Victorb101/DC-DC-Converter/Board Preview.png

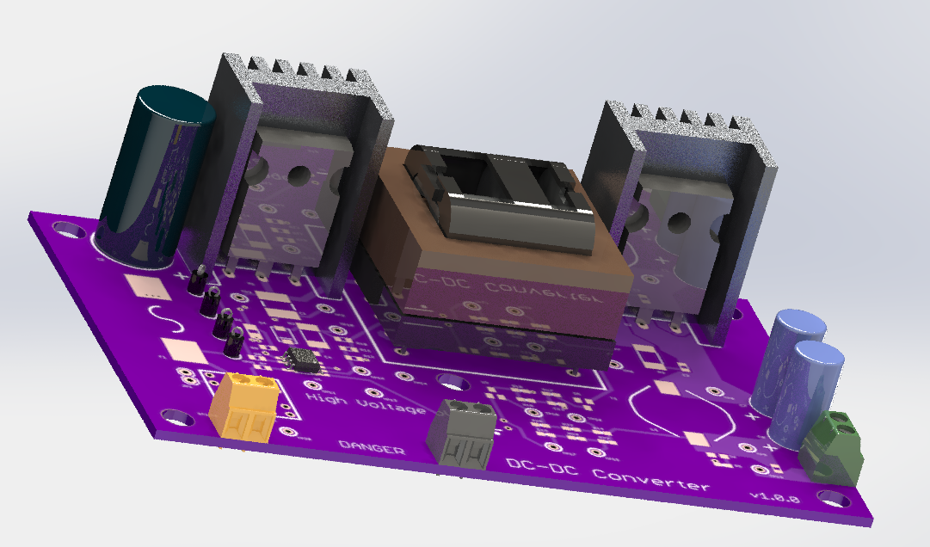
Board Preview.png
