Victorb101/DC-DC-Converter/Board Bottom.png

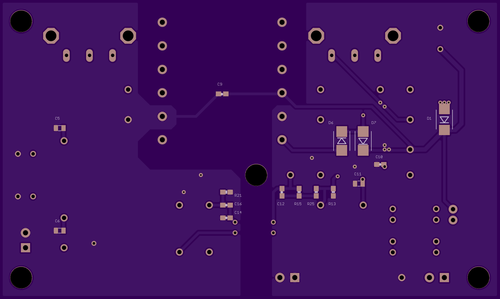
Board Bottom.png
