Victorb101/DC-DC-Converter/Board Top.png

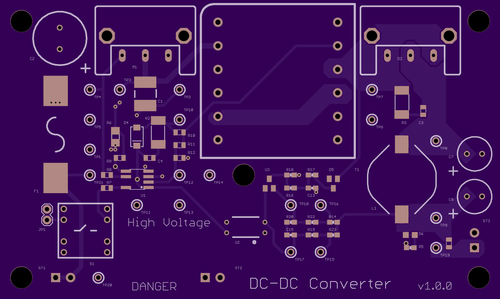
Board Top.png
