Victorb101/DC-DC-Converter/V_SNUB-PGND-Short.png

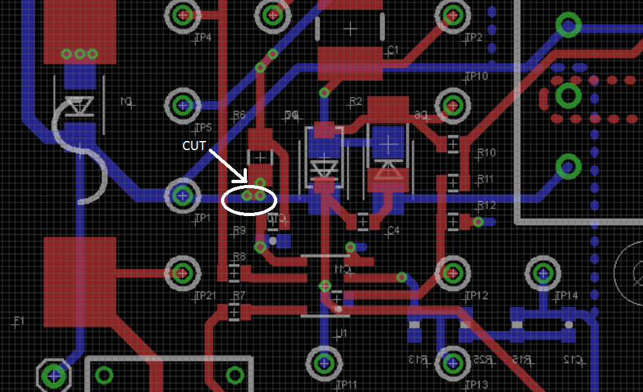
V_SNUB-PGND-Short.png
