Victorb101/DC-DC-Converter/DC-DC - Backup/BOM.xlsx

Component Type | Description | Value | Manufacturer P/N | Vendor | Vendor P/N | Package | Quantity | Need Range? | Notes
Flyback Driver | Controller (no opto) |  | UCC 28710D | Newark | 53W1981 | SOIC-7 | 1
Diode | RVP |  | STTH2L06A | DK | 497-3549-1-ND | DO-214AC, SMA | 1
MOSFET | Switch |  | IPW90R120C3 | Newark | 33P7199 | TO-247 | 1
Fuse Holder | 20mm |  | 31.8221 | DK | 486-1260-ND |  | 1
Transformer | 35:02:02 | 600uH | 7608954431 | DK | 732-5062-ND |  | 2
Button | Pushbutton |  | 15551 | DK | 679-1964-ND |  | 1
Button Cap |  |  | 1630008 | DK | 679-1973-ND |  | 1
Button Cover |  |  | 1631009 | DK | 679-1995-ND |  | 1
Heat Sink |  | 5C/W | WA-DT2-101E | DK | WA-DT2-101E-ND |  | 1
Resistor | Power - 20W | 200 | MP930-200-1% | Newark | 02H2384 | TO-220 | 1 | X | 150-200-220-250-300-400 values
Resistor | Power - 2W | 10 | CRM2512-FX-10R0ELF | Newark | 87W5948 | 2512 | 2 | X
Fuse | Quick Blow | 1A | S500-1-R. | Newark | 92K9961 | 5x20 | 2 |  | Add 2A value, 2 fuses
Screw Terminal | Orange | 2-pos | 1760490000 | Newark | 18M9779 | 5mm | 1
Screw Terminal | Black | 2-pos | 1760510000 | Newark | 14C0195 | 5mm | 1
Screw Terminal | Green | 2-pos | PT1,5/2-5.0-H | Newark | 70R0063 | 5mm | 1
Capacitor | Input | 22u | 450PX22MEFC12.5X25 | Newark | 39T8964 | 5mm | 1
Capacitor | FET Snub | 1u | CKG57NX7T2J105M500JH | DK | 445-7110-2-ND | 5x6mm | 1
Resistor | FET Snub | 100k | MC25121WF1003T4E | Newark | 04P1636 | 2512 | 1 | X
Diode | FET Snub |  | USB260-E3/52T | Newark | 12M3626 | DO-214AA | 1
Diode | Rectifier | 0.5V | STPS60L45CW | DK | 497-3745-5-ND | TO-247 | 1
Heat Sink | For Rectifier |  | WV-T247-101E | Newark | 10R0490 |  | 1
Capacitor | Rectifier Snub | 0.1u | CC0805KRX7R9BB104 | Newark | 68R4910 | 805 | 2 | X
Capacitor | Output Filter | 1u | CC0805KKX7R7BB105 | Newark | 68R4880 | 805 | 2
Capacitor | Output Filter | 270u | EEU-FR1V271L | Newark | 74R3460 | 3.5mm | 2
Inductor | Output Filter | 1u | MCBF7330-1R0MU | Newark | 74R9899 |  | 1
LED |  |  | SML-LX0805SUGC-TR | Newark | 19J8848 |  | 1
Resistor | LED | 500 | MC0063W06031510R | Newark | 58K4616 | 603 | 1
Resistor | CS | 0.25 | LRC-LR1206LF-01-R250-F | Newark | 70K8688 | 1206 | 1 | X
Resistor | CS | 3.16 | MC01W080513R16 | Newark | 94W6205 | 805 | 1 | X
Resistor |  | 0 | RC0805JR-130RL | Newark | 68R0285 | 805 | 2
Resistor | VS | 76.8k | ERJ-6ENF7682V | Newark | 53W4908 | 805 | 1
Resistor | VS | 47.5k | MC01W0805147K5 | Newark | 94W6286 | 805 | 1
Capacitor | VDD | 2.2u | C2012X7R1H225K125AC | Newark | 04X3290 | 805 | 1
Diode | VDD |  | GS1M-LTP | Newark | 51T4906 | DO-214AC | 1
Test Point |  |  | 5001 | Newark | 62W5135 |  | 10
Jumper |  |  | SPC19807 | Newark | 84K8569 | .1" | 3
Pin Header | 2 pos for jumper |  | 3-641215-2 | Newark | 52K3568 | .1" | 3
Resistor | Shunt | 0.01 | CRF0805-FX-R010ELF | Newark | 16X9679 | 805 | 1
Extras
Diode | Opto |  | BAS16-7-F | Newark | 65W8443 | SOT-23 | 1
Optocoupler | Opto |  | LTV-817A | DK | 160-2037-5-ND |  | 1
Programmable Shunt | Opto |  | TL431AIDBZT | Newark | 44J2372 | SOT-23 | 1
Future?
Heat Sink |  | 5C/W | 529801B02500G | Newark | 18M8163 |  | 1
Flyback Driver | Controller |  | UCC28740D | Newark | 12X8832 | SOIC-7 | 1
Diode | Rectifier | 0.42V | SBR10U45SP5-13 | DK | SBR10U45SP5-13DICT-ND
http://www.showmecables.com/product/DB9-Female-Terminal-Block-Panel-Mount-Connectors.aspx
