Victorb101/DC-DC-Converter/DC-DC/BOM.xlsx

Component Type | Description | Value | Manufacturer P/N | Vendor | Vendor P/N | Quantity | Unit Cost | Link
Newark Parts
Flyback Driver | Controller (no opto) |  | UCC 28710D | Newark | 53W1981 | 10 | 1.55 | http://www.newark.com/texas-instruments/ucc28710d/flyback-controller-680hz-9v-35v/dp/53W1981?CMP=AFC-OP
MOSFET | Switch |  | IPW90R120C3 | Newark | 33P7199 | 3 | 14.32 | http://www.newark.com/infineon/ipw90r120c3/n-channel-mosfet-900v-36a-to-247/dp/33P7199?ost=IPW90R120C3
Diode | FET Snub |  | USB260-E3/52T | Newark | 12M3626 | 8 | 0.5 | http://www.newark.com/vishay-general-semiconductor/usb260-e3-52t/fast-diode-2a-600v-do-214aa/dp/12M3626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
Resistor | Power - 2W | 10 | CRM2512-FX-10R0ELF | Newark | 87W5948 | 4 | 0.479 | http://www.newark.com/bourns/crm2512-fx-10r0elf/resistor-thick-film-10-ohm-1-2512/dp/87W5948?CMP=AFC-OP
 | 1W | 20 | MC25121WF200JT4E | Newark | 04P1639 | 4 | 0.178 | http://www.newark.com/multicomp/mc25121wf200jt4e/resistor-thick-film-20-ohm-1w/dp/04P1639?CMP=AFC-OP
 | 2mW | 100 | CRCW2512100RFKEG | Newark | 53K3944 | 4 | 0.35 | http://www.newark.com/vishay-dale/crcw2512100rfkeg/resistor-thick-film-chip-100-ohm/dp/53K3944?ost=53K3944
Fuse | Quick Blow | 1.5A | 048501.5DR | Newark | 69W6465 | 4 | 2.92 | http://www.newark.com/littelfuse/048501-5dr/fuse-smd-1-5a-fast-acting/dp/69W6465?CMP=AFC-OP
Screw Terminal | Orange | 2-pos | 1760490000 | Newark | 18M9779 | 2 | 0.675 | http://www.newark.com/weidmuller/1760490000/terminal-block-pcb-2pos-24-14awg/dp/18M9779?ost=18M9779
Screw Terminal | Black | 2-pos | 1760510000 | Newark | 14C0195 | 2 | 0.675 | http://www.newark.com/weidmuller/1760510000/terminal-block-pcb-2pos-24-14awg/dp/14C0195?ost=1760510000
Screw Terminal | Green | 2-pos | PT1,5/2-5.0-H | Newark | 70R0063 | 2 | 0.38 | http://www.newark.com/phoenix-contact/pt1-5-2-5-0-h/term-block-pcb-screw-5-0mm-2way/dp/70R0063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
Capacitor | Input | 22u | 450PX22MEFC12.5X25 | Newark | 39T8964 | 2 | 2.16 | http://www.newark.com/rubycon/450px22mefc12-5x25/capacitor-alum-elec-22uf-450v/dp/39T8964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
Capacitor | Rectifier Snub | 0.1u | CC0805KRX7R9BB104 | Newark | 68R4910 | 4 | 0.018 | http://www.newark.com/yageo/cc0805krx7r9bb104/capacitor-ceramic-0-1uf-50v-x7r/dp/68R4910?ost=68R4910
 |  | 0.01u | CC0805KRX7R9BB103 | Newark | 68R4909 | 4 | 0.017 | http://www.newark.com/yageo/cc0805krx7r9bb103/capacitor-ceramic-0-01uf-50v-x7r/dp/68R4909
 |  | 0.033u | MC0805B333K500CT | Newark | 06R3835 | 4 | 0.005 | http://www.newark.com/multicomp/mc0805b333k500ct/capacitor-ceramic-0-033uf-50v/dp/06R3835?ost=06R3835
 |  | 1u | UMK212BJ105KG-T | Newark | 84R9159 | 4 | 0.137 | http://www.newark.com/taiyo-yuden/umk212bj105kg-t/capacitor-ceramic-1uf-50v-x5r/dp/84R9159?ost=84R9159
 |  | 0.22u | C0805C224K5RACTU | Newark | 70K9140 | 4 | 0.117 | http://www.newark.com/kemet/c0805c224k5ractu/capacitor-ceramic-0-22uf-50v-x7r/dp/70K9140?ost=70K9140
Capacitor | Output Filter | 1u | CC0805KKX7R7BB105 | Newark | 68R4880 | 4 | 0.025 | http://www.newark.com/yageo/cc0805kkx7r7bb105/capacitor-ceramic-1uf-16v-x7r/dp/68R4880?ost=68R4880
Capacitor | Output Filter | 270u | EEU-FR1V271L | Newark | 74R3460 | 4 | 0.475 | http://www.newark.com/panasonic/eeu-fr1v271l/capacitor-alum-elec-270uf-35v/dp/74R3460?ost=74R3460
Inductor | Output Filter | 1u | MCBF7330-1R0MU | Newark | 74R9899 | 2 | 0.2 | http://www.newark.com/multicomp/mcbf7330-1r0mu/inductor-1uh-12arms-20/dp/74R9899?ost=74R9899
LED | Green |  | SML-LX0805SUGC-TR | Newark | 19J8848 | 2 | 0.169 | http://www.newark.com/lumex/sml-lx0805sugc-tr/led-green-1-25mm-x-1-4mm-45mcd/dp/19J8848?ost=19J8848
Resistor | LED | 500 | MC0063W06031510R | Newark | 58K4616 | 2 | 0.015 | http://www.newark.com/multicomp/mc0063w06031510r/resistor-510r-0-063w-1-0603/dp/58K4616?ost=58K4616
Resistor | CS | 0.25 | LRC-LR1206LF-01-R250-F | Newark | 70K8688 | 2 | 0.432 | http://www.newark.com/international-resistive/lrc-lr1206lf-01-r250-f/resistor-cur-sense-0-25-ohm-500mw/dp/70K8688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
 |  | 0.1 | CRL1206-FW-R100ELF | Newark | 32K1574 | 2 | 0.404 | http://www.newark.com/bourns/crl1206-fw-r100elf/resistor-thick-film-0-1-ohm-250mw/dp/32K1574?ost=32K1574
 |  | 0.2 | CRL1206-FW-R200ELF | Newark | 32K1581 | 2 | 0.404 | http://www.newark.com/bourns/crl1206-fw-r200elf/resistor-thick-film-0-2-ohm-250mw/dp/32K1581?ost=32K1581
 |  | 0.68 | RL1632R-R680-F | Newark | 28K1721 | 2 | 0.065 | http://www.newark.com/susumu/rl1632r-r680-f/resistor-cur-sense-0-68-ohm-500mw/dp/28K1721?ost=28K1721
Resistor | CS | 3.16 | MC01W080513R16 | Newark | 94W6205 | 2 | 0.048 | http://www.newark.com/multicomp/mc01w080513r16/resistor-3r16-0-1w-1-0805/dp/94W6205?ost=94W6205
Resistor |  | 0 | RC0805JR-130RL | Newark | 68R0285 | 8 | 0.05 | http://www.newark.com/yageo/rc0805jr-130rl/resistor-thick-film-0-ohm-125mw/dp/68R0285?ost=68R0285
Resistor | VS | 76.8k | ERJ-6ENF7682V | Newark | 53W4908 | 2 | 0.096 | http://www.newark.com/panasonic/erj-6enf7682v/resistor-thick-film-76-8kohm-125mw/dp/53W4908?ost=53W4908
Resistor | VS | 47.5k | MC01W0805147K5 | Newark | 94W6286 | 2 | 0.058 | http://www.newark.com/multicomp/mc01w0805147k5/resistor-47k5-0-1w-1-0805/dp/94W6286?ost=94W6286
 |  | 43k | ERJ-6ENF4302V | Newark | 53W4849 | 2 | 0.09 | http://www.newark.com/panasonic/erj-6enf4302v/resistor-thick-film-43kohm-125mw/dp/53W4849
 |  | 45.3k | ERJ-6ENF4532V | Newark | 53W4856 | 2 | 0.096 | http://www.newark.com/panasonic/erj-6enf4532v/resistor-thick-film-45-3kohm-125mw/dp/53W4856
 |  | 49.9k | CRCW080549K9FKEB | Newark | 65J2106 | 2 | 0.084 | http://www.newark.com/vishay-dale/crcw080549k9fkeb/resistor-thick-film-49-9kohm-125mw/dp/65J2106
 |  | 52.3k | ERJ-6ENF5232V | Newark | 53W4867 | 2 | 0.096 | http://www.newark.com/panasonic/erj-6enf5232v/resistor-thick-film-52-3kohm-125mw/dp/53W4867
Capacitor | VDD | 2.2u | C2012X7R1H225K125AC | Newark | 04X3290 | 2 | 0.509 | http://www.newark.com/tdk/c2012x7r1h225k125ac/cap-ceramic-2-2uf-50v-x7r-0805/dp/04X3290?ost=04X3290
Diode | VDD |  | GS1M-LTP | Newark | 51T4906 | 2 | 0.421 | http://www.newark.com/micro-commercial-components/gs1m-ltp/standard-recovery-1a-1kv-do-214ac/dp/51T4906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
Test Point |  |  | 5001 | Newark | 62W5135 | 42 | 0.379 | http://www.newark.com/keystone/5001/test-point-pcb-through-hole/dp/62W5135?ost=62W5135
Jumper |  |  | SPC19807 | Newark | 84K8569 | 3 | 2.36 | http://www.newark.com/multicomp/spc19807/mini-jumper-2pos-2-54mm/dp/84K8569?ost=84K8569
Resistor | Shunt | 0.01 | CRF0805-FX-R010ELF | Newark | 16X9679 | 2 | 0.501 | http://www.newark.com/bourns/crf0805-fx-r010elf/resistor-thick-film-0-01ohm-1/dp/16X9679?ost=16X9679
Diode | Opto |  | BAS16-7-F | Newark | 65W8443 | 2 | 0.074 | http://www.newark.com/multicomp/bas16-7-f/diode-ultrafast-recovery-250ma/dp/65W8443?ost=65W8443
Programmable Shunt | Opto |  | TL431AIDBZT | Newark | 44J2372 | 2 | 0.359 | http://www.newark.com/texas-instruments/tl431aidbzt/ic-prog-shunt-v-ref-2-495v-1-3/dp/44J2372?CMP=AFC-OP
Flyback Driver | Controller |  | UCC28740D | Newark | 12X8832 | 2 | 1.43 | http://www.newark.com/texas-instruments/ucc28740d/ic-cv-cc-flybk-controller-38v/dp/12X8832?CMP=AFC-OP
Digi-Key Parts
Diode | RVP |  | STTH2L06A | DK | 497-3549-1-ND | 3 | 0.6 | http://www.digikey.com/product-detail/en/STTH2L06A/497-3549-1-ND/1014952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
Transformer | 35:02:02 | 600uH | 7608954431 | DK | 732-5062-ND | 2 | 18.36 | http://www.digikey.com/product-search/en?KeyWords=732-5062-ND&WT.z_header=search_go
Button | Pushbutton |  | 15551 | DK | 679-1964-ND | 2 | 4.18 | http://www.digikey.com/product-search/en?KeyWords=679-1964-ND&WT.z_header=search_go
Button Cap |  |  | 1630008 | DK | 679-1973-ND | 2 | 0.65 | http://www.digikey.com/product-search/en?KeyWords=679-1973-ND&WT.z_header=search_go
Button Cover |  |  | 1631009 | DK | 679-1995-ND | 2 | 0.62 | http://www.digikey.com/product-search/en?KeyWords=679-1995-ND&WT.z_header=search_go
Capacitor | FET Snub | 1u | CKG57NX7T2J105M500JH | DK | 445-7110-2-ND | 2 | 5.05 | http://www.digikey.com/product-detail/en/CKG57NX7T2J105M500JH/445-7110-1-ND/2675016
 |  | 0.68u | CKG57NX7T2J684M500JH | DK | 445-10516-1-ND | 2 | 5.05 | http://www.digikey.com/product-detail/en/CKG57NX7T2J684M500JH/445-10516-1-ND/3932443
 |  | 1.5u | CKG57NX7T2W155M500JH | DK | 445-10518-1-ND | 2 | 5.05 | http://www.digikey.com/product-detail/en/CKG57NX7T2W155M500JH/445-10518-1-ND/3932445
 |  | 0.47u | CKG57NX7R2J474M500JH | DK | 445-2401-1-ND | 2 | 5.05 | http://www.digikey.com/product-detail/en/CKG57NX7R2J474M500JH/445-2401-1-ND/790022
Heat Sink | For Rectifier |  | WV-T247-101E | DK | WV-T247-101E-ND | 4 | 2.13 | http://www.digikey.com/product-detail/en/WV-T247-101E/WV-T247-101E-ND/2071312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
Diode | Rectifier | 0.5V | STPS60L45CW | DK | 497-3745-5-ND | 4 | 4.79 | http://www.digikey.com/product-search/en?KeyWords=497-3745-5-ND&WT.z_header=search_go
Pin Header |  | 2-pos | 961102-6404-AR | DK | 3M9447-ND | 2 | 0.16 | http://www.digikey.com/product-detail/en/961102-6404-AR/3M9447-ND/2071488
Optocoupler | Opto |  | LTV-817A | DK | 160-2037-5-ND | 2 | 0.41 | http://www.digikey.com/product-detail/en/LTV-817A/160-2037-5-ND/3199509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
Capacitor | Input | 4.7u | UPS2W4R7MHD1TO | DK | 493-5420-1-ND | 1 | 0.79 | http://www.digikey.com/product-detail/en/UPS2W4R7MHD1TO/493-5420-1-ND/3129757
Osh-Park Order
PCB | DC-DC |  |  | Osh-Park |  | 3 | 21.15
 |  |  |  |  |  | Total | 306.504
