Victorb101/DC-DC-Converter/DC-DC Enclosure/DC-DC Parts/XFMR.SLDASM

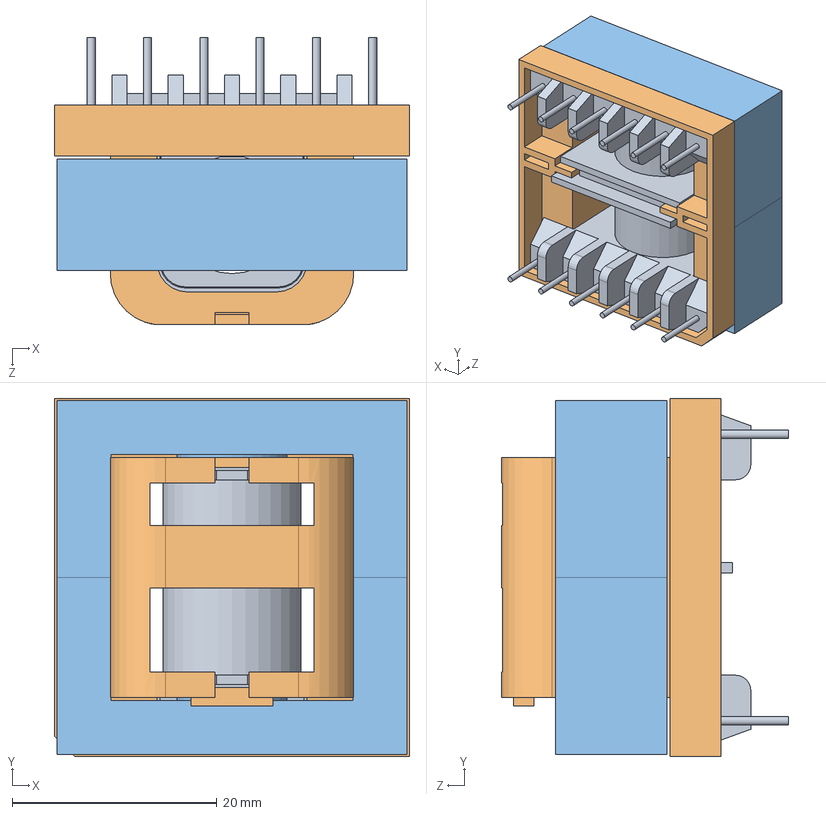
[picture p5: CAD file, 2015-01-29]
DC-DC Enclosure/DC-DC Parts/XFMR.SLDASM
34.7 x 35.0 x 28.1 mm
Bobbin_ETD34
Cover_ETD34
Core_ETD34 x 2
