Victorb101/DC-DC-Converter/DC-DC Enclosure/DC-DC Parts/Heatsink.SLDPRT

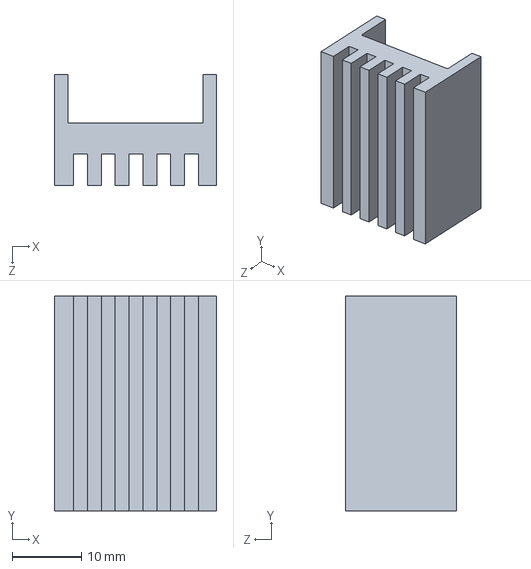
[picture p6: CAD file, 2015-01-29]
DC-DC Enclosure/DC-DC Parts/Heatsink.SLDPRT
23.4 x 31.0 x 16.0 mm
