Victorb101/DC-DC-Converter/DC-DC Enclosure/DC-DC Parts/8mCap.SLDPRT

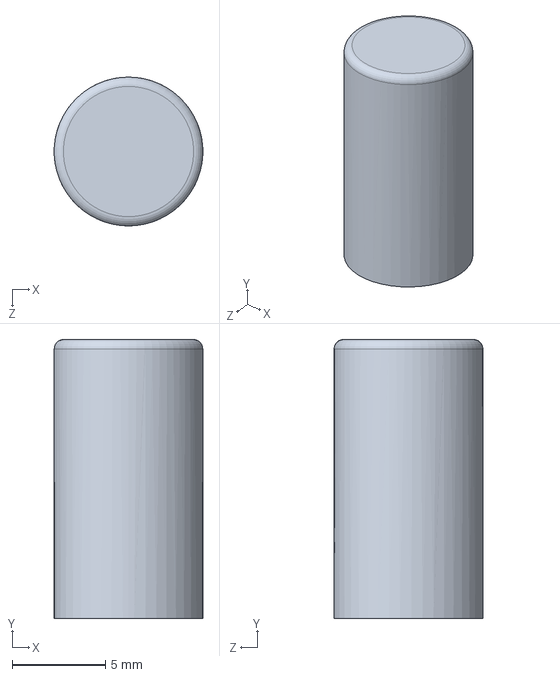
[picture p7: CAD file, 2015-01-29]
DC-DC Enclosure/DC-DC Parts/8mCap.SLDPRT
7.99 x 15.0 x 8.00 mm
