Victorb101/DC-DC-Converter/DC-DC Enclosure/DC-DC Parts/User Library-TO-247.SLDPRT

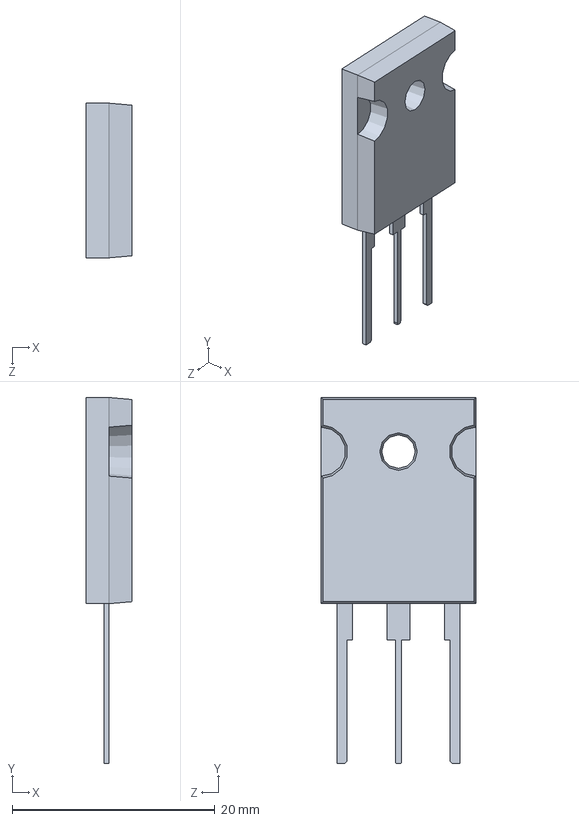
[picture p8: CAD file, 2015-01-29]
DC-DC Enclosure/DC-DC Parts/User Library-TO-247.SLDPRT
4.57 x 36.1 x 15.2 mm
