Victorb101/DC-DC-Converter/DC-DC Enclosure/DC-DC Parts/PCB.SLDPRT

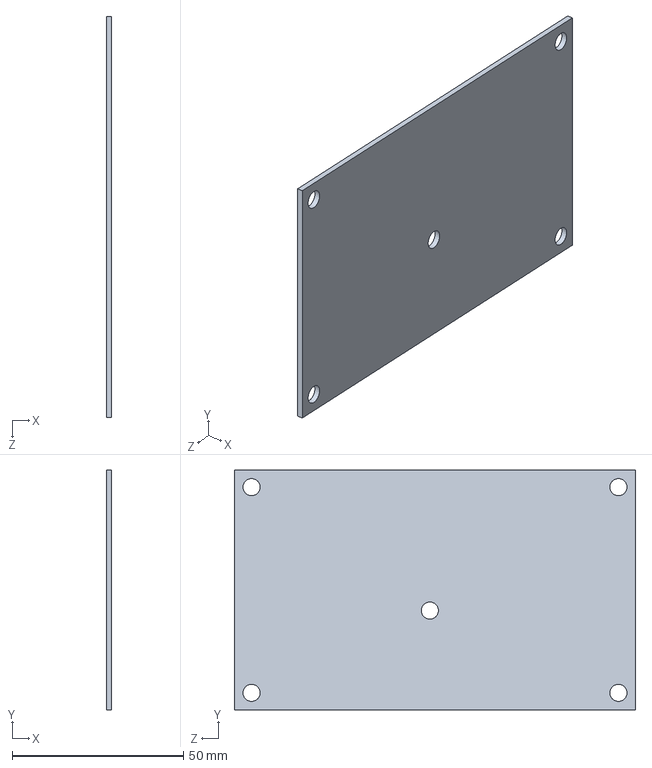
[picture p9: CAD file, 2015-01-29]
DC-DC Enclosure/DC-DC Parts/PCB.SLDPRT
1.60 x 70.0 x 117.0 mm
