Victorb101/DC-DC-Converter/DC-DC Enclosure/DC-DC Parts/User Library-SOIC-8-1.SLDPRT

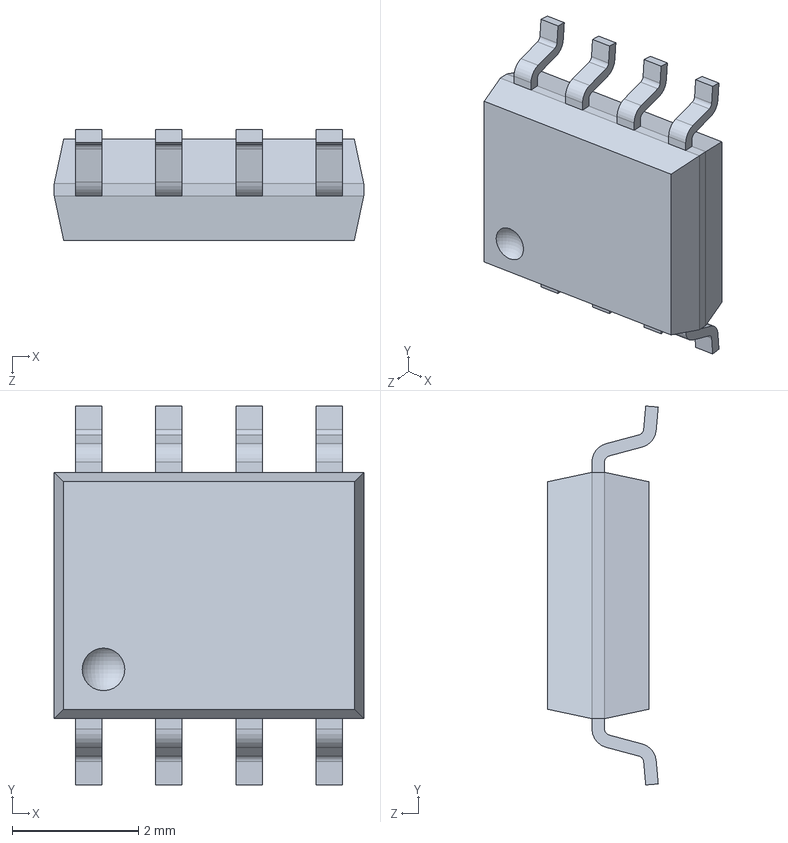
[picture p10: CAD file, 2015-01-29]
DC-DC Enclosure/DC-DC Parts/User Library-SOIC-8-1.SLDPRT
4.90 x 6.00 x 1.75 mm
