Victorb101/DC-DC-Converter/DC-DC Enclosure/DC-DC Parts/12mCap.SLDPRT

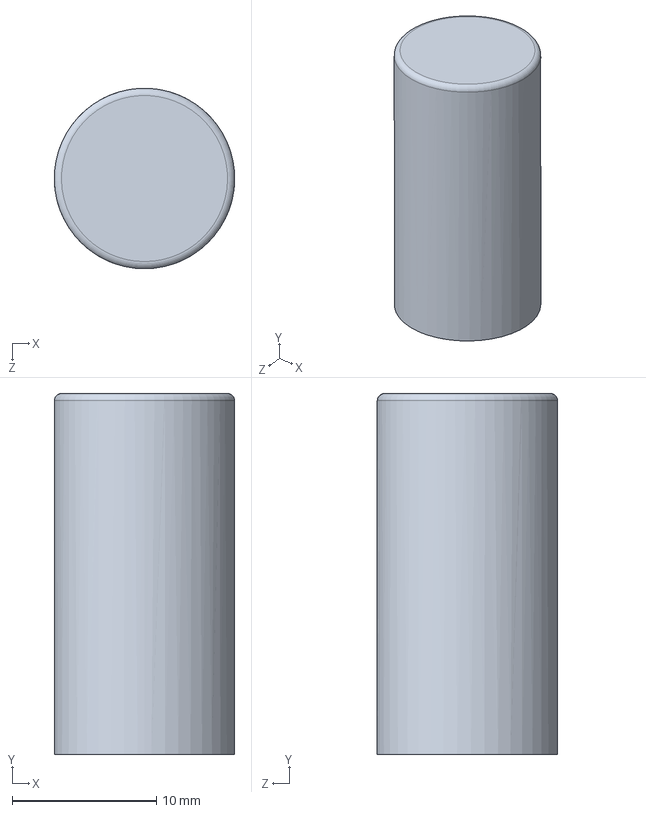
[picture p11: CAD file, 2015-01-29]
DC-DC Enclosure/DC-DC Parts/12mCap.SLDPRT
12.5 x 25.0 x 12.5 mm
