Victorb101/DC-DC-Converter/DC-DC Enclosure/DC-DC Parts/14005.SLDPRT

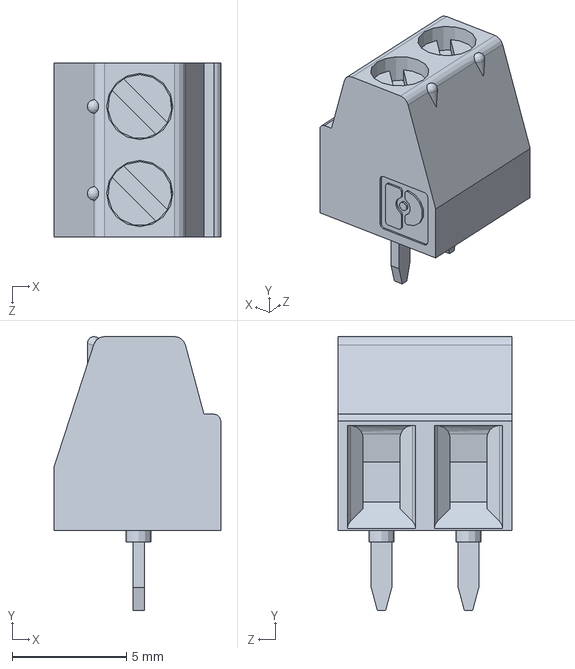
[picture p12: CAD file, 2015-01-29]
DC-DC Enclosure/DC-DC Parts/14005.SLDPRT
7.30 x 12.0 x 7.62 mm
