Victorb101/DC-DC-Converter/DC-DC Enclosure/DC-DC Parts/User Library-Test Point Keystone - 5001 BLACK.SLDASM

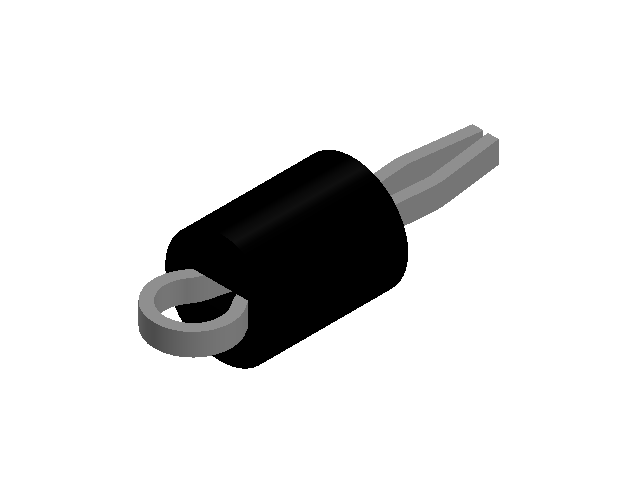
[picture p13: CAD file, 2015-01-29]
DC-DC Enclosure/DC-DC Parts/User Library-Test Point Keystone - 5001 BLACK.SLDASM
User Library-Test Point Keystone - 5001 BLACK_1
User Library-Test Point Keystone - 5001 BLACK_2
