Victorb101/DC-DC-Converter/(list of files, cad)

Other CAD files:
DC-DC Enclosure/DC-DC Parts/Bobbin_ETD34.sldprt
DC-DC Enclosure/DC-DC Parts/User Library-Test Point Keystone - 5001 BLACK_1.sldprt
DC-DC Enclosure/DC-DC Parts/Cover_ETD34.sldprt
DC-DC Enclosure/DC-DC Parts/Core_ETD34.sldprt
DC-DC Enclosure/DC-DC Parts/User Library-Test Point Keystone - 5001 BLACK_2.sldprt
