Victorb101/DC-DC-Converter/Testing/11-17-14/TEST1.png

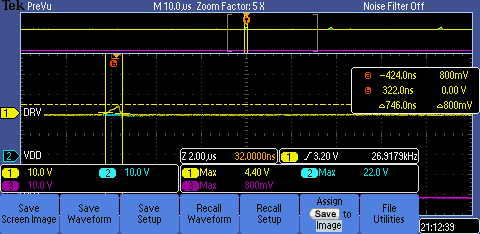
Testing/11-17-14/TEST1.png
