Victorb101/DC-DC-Converter/Testing/11-17-14/TEST1_2.png

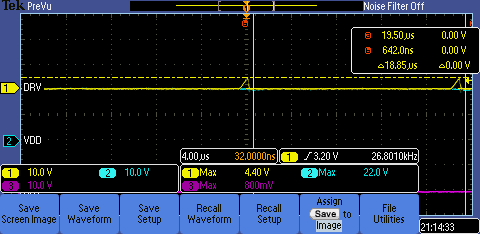
Testing/11-17-14/TEST1_2.png
