Victorb101/DC-DC-Converter/Testing/11-28-14/Test1_3.png

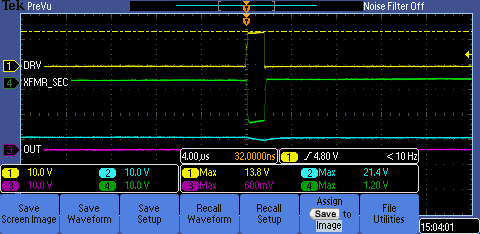
Testing/11-28-14/Test1_3.png
