Victorb101/DC-DC-Converter/Testing/11-28-14/Test3_1.PNG

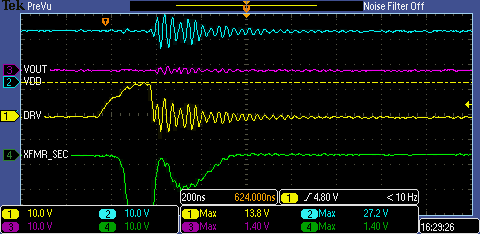
Testing/11-28-14/Test3_1.PNG
