Victorb101/DC-DC-Converter/Testing/11-30-14/Test1-2.png

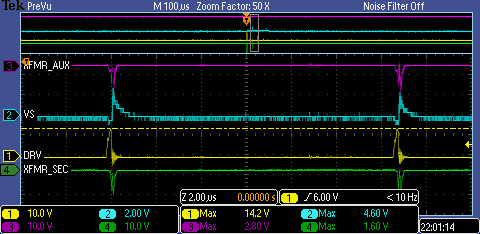
Testing/11-30-14/Test1-2.png
