Victorb101/DC-DC-Converter/Testing/11-30-14/Test2-1.PNG

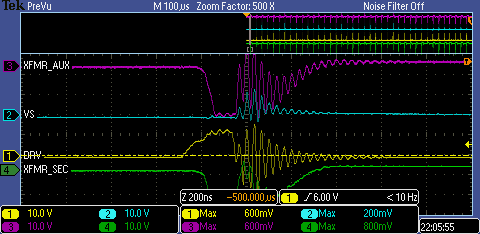
Testing/11-30-14/Test2-1.PNG
