Victorb101/DC-DC-Converter/Testing/11-30-14/Test2-2.PNG

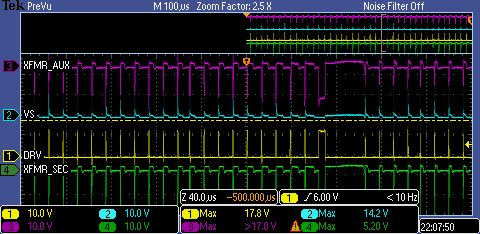
Testing/11-30-14/Test2-2.PNG
