Victorb101/DC-DC-Converter/Testing/Summary 1-22-15/TEK00005.PNG

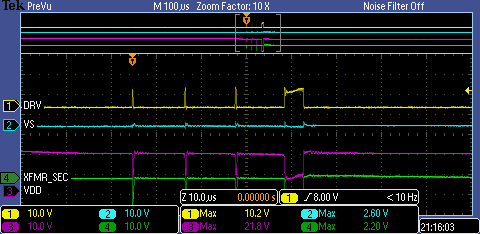
Testing/Summary 1-22-15/TEK00005.PNG
