Victorb101/DC-DC-Converter/Testing/Summary 1-22-15/TEK00007.PNG

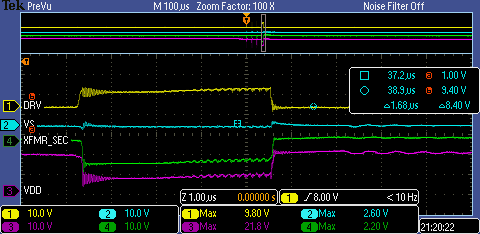
Testing/Summary 1-22-15/TEK00007.PNG
