Victorb101/DC-DC-Converter/Testing/Summary 1-22-15/DC-DC Converter v1.1.pdf

# Sheet 1/3

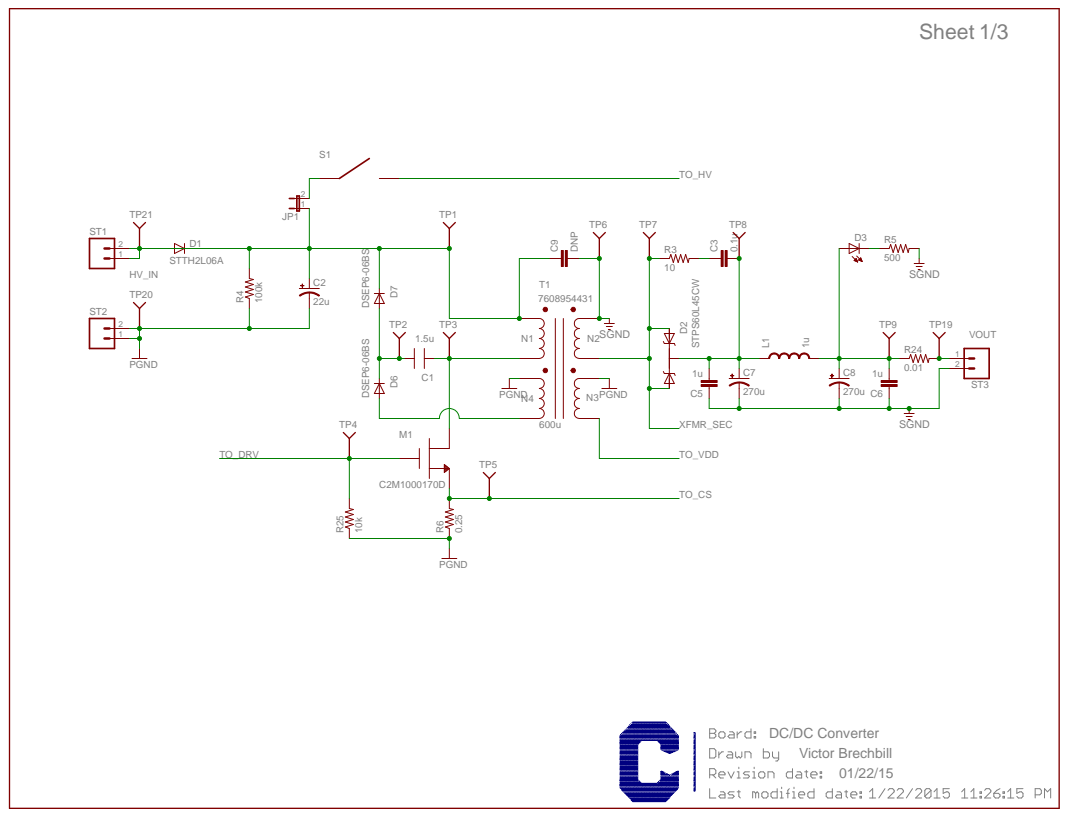
[picture p34: page 1]

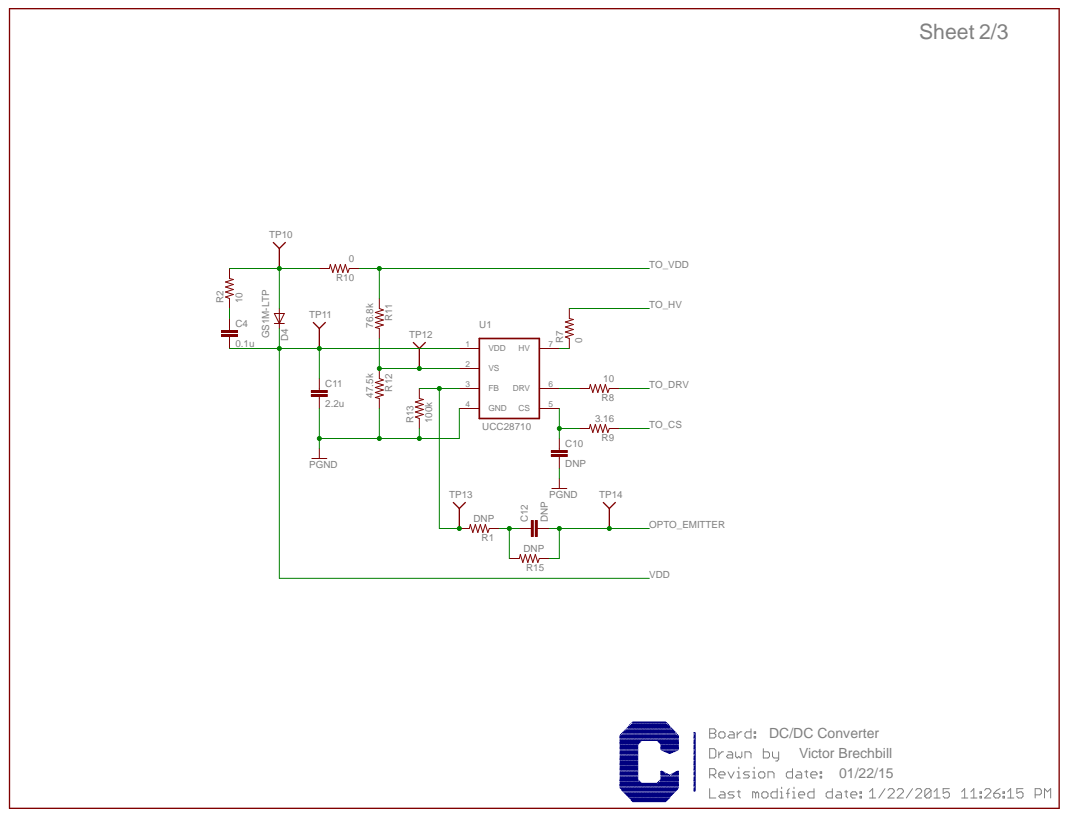
[picture p35: page 2]

# Optocoupler feedback circuit for future development with UCC28740

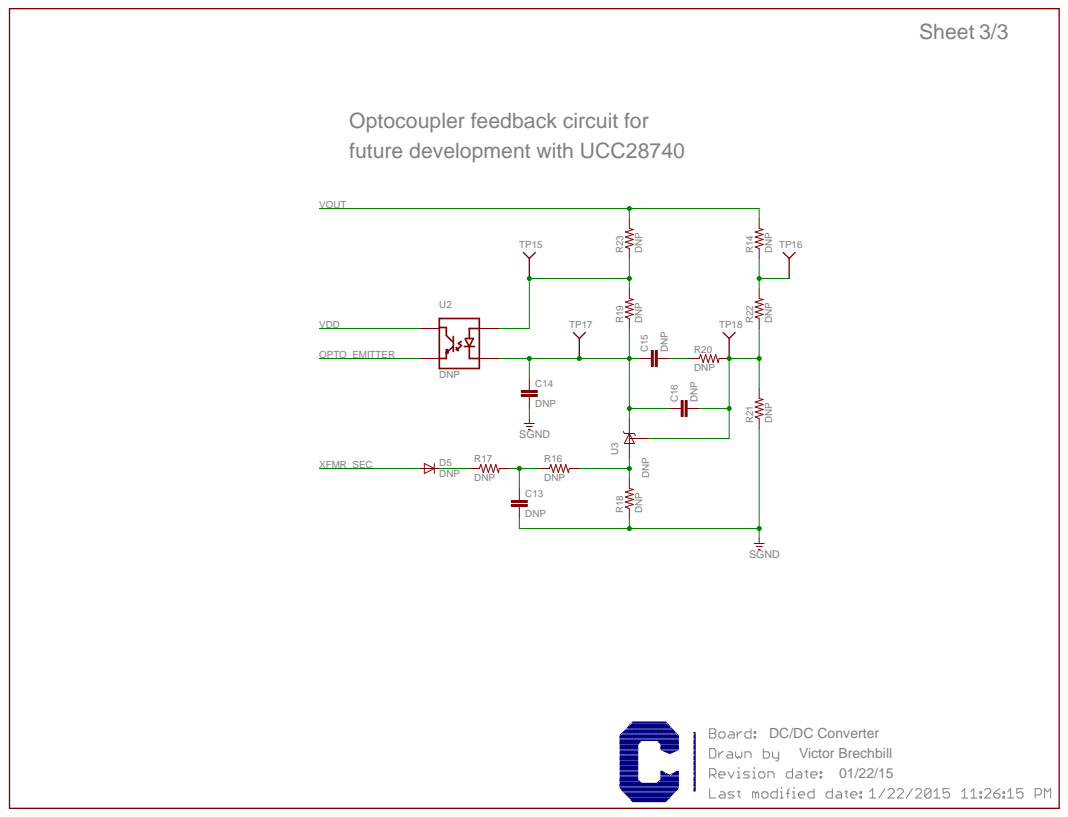
[picture p36: page 3]
