Victorb101/DC-DC-Converter/DC-DC Converter v1.1.pdf

# Sheet 1/3

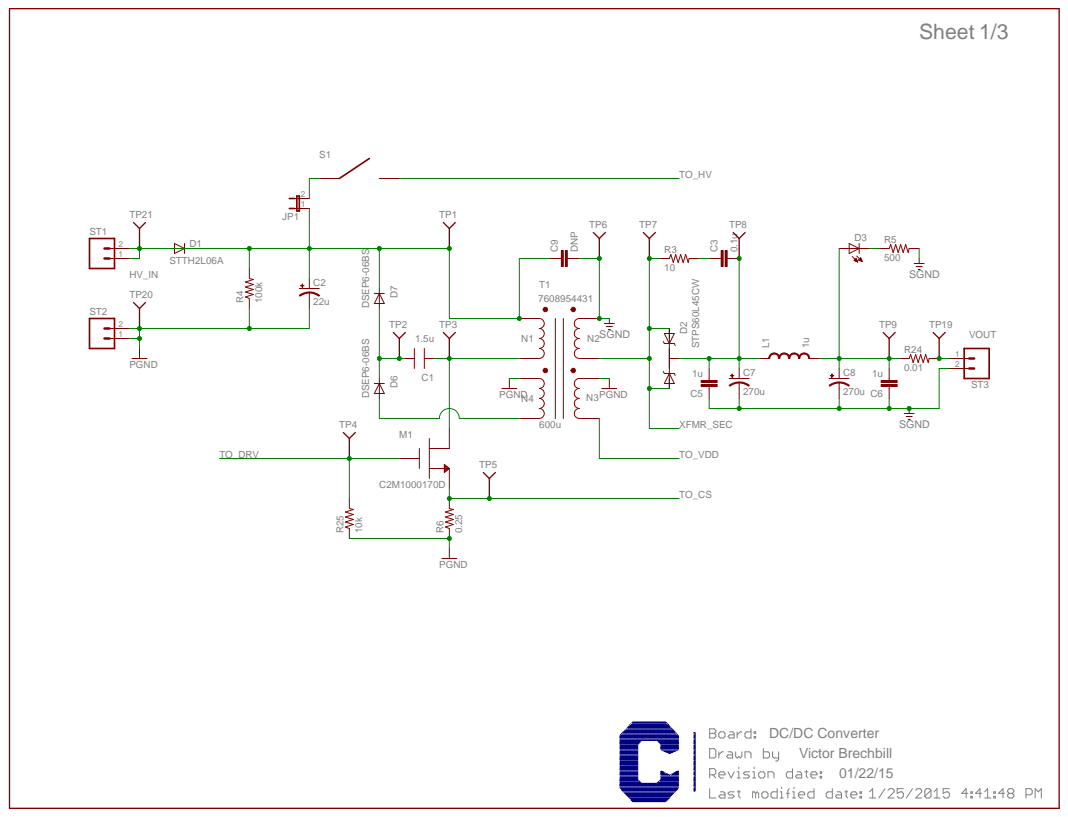
[picture p37: page 1]

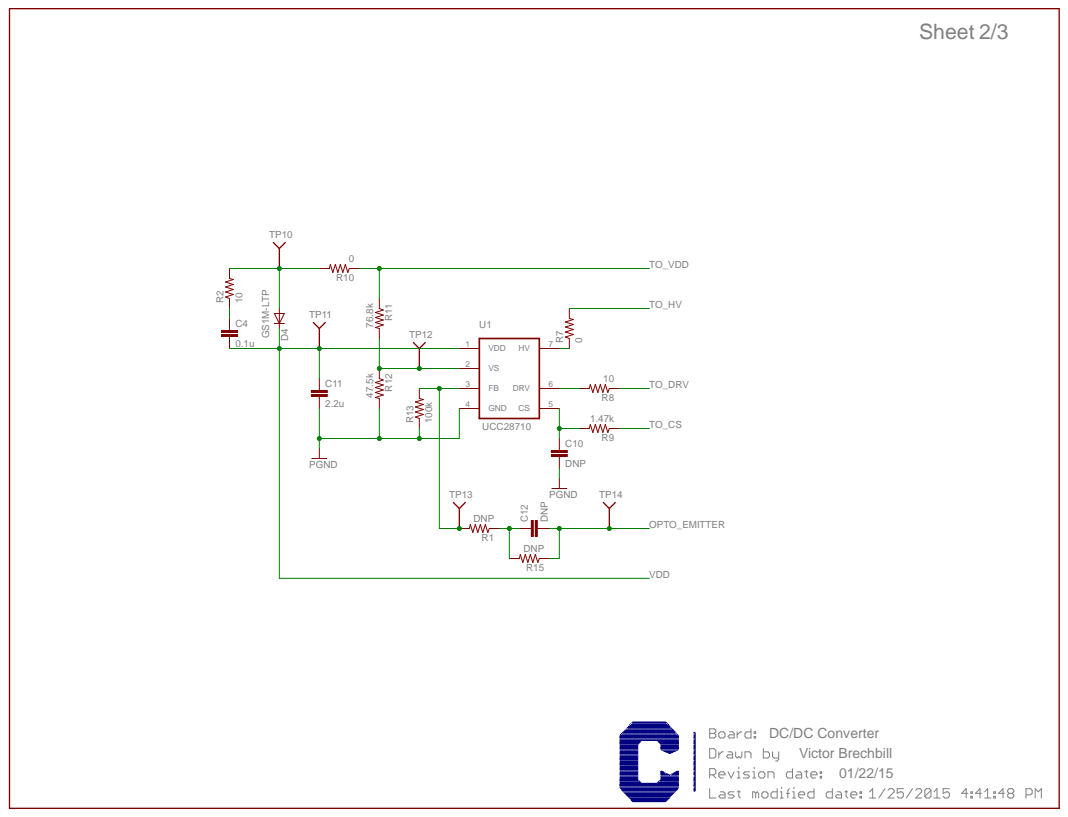
[picture p38: page 2]

# Optocoupler feedback circuit for future development with UCC28740

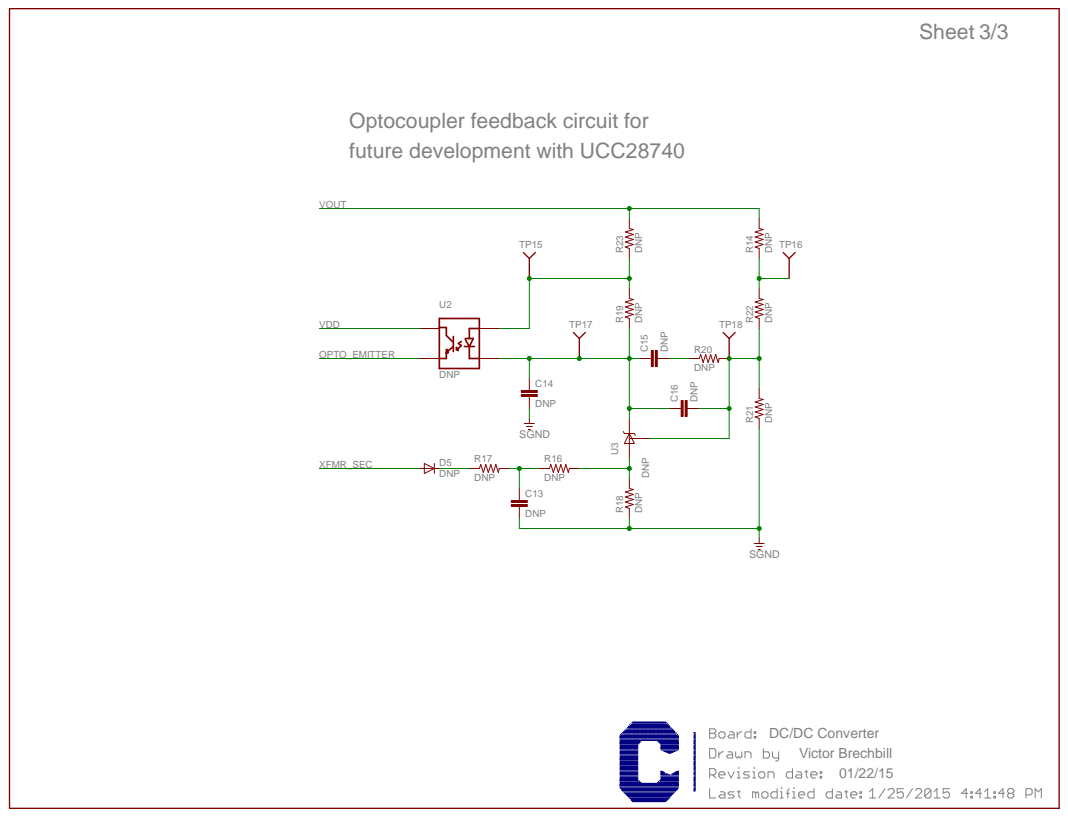
[picture p39: page 3]
