Victorb101/DC-DC-Converter/DC-DC-v1.0.0.pdf

# Sheet 1/3

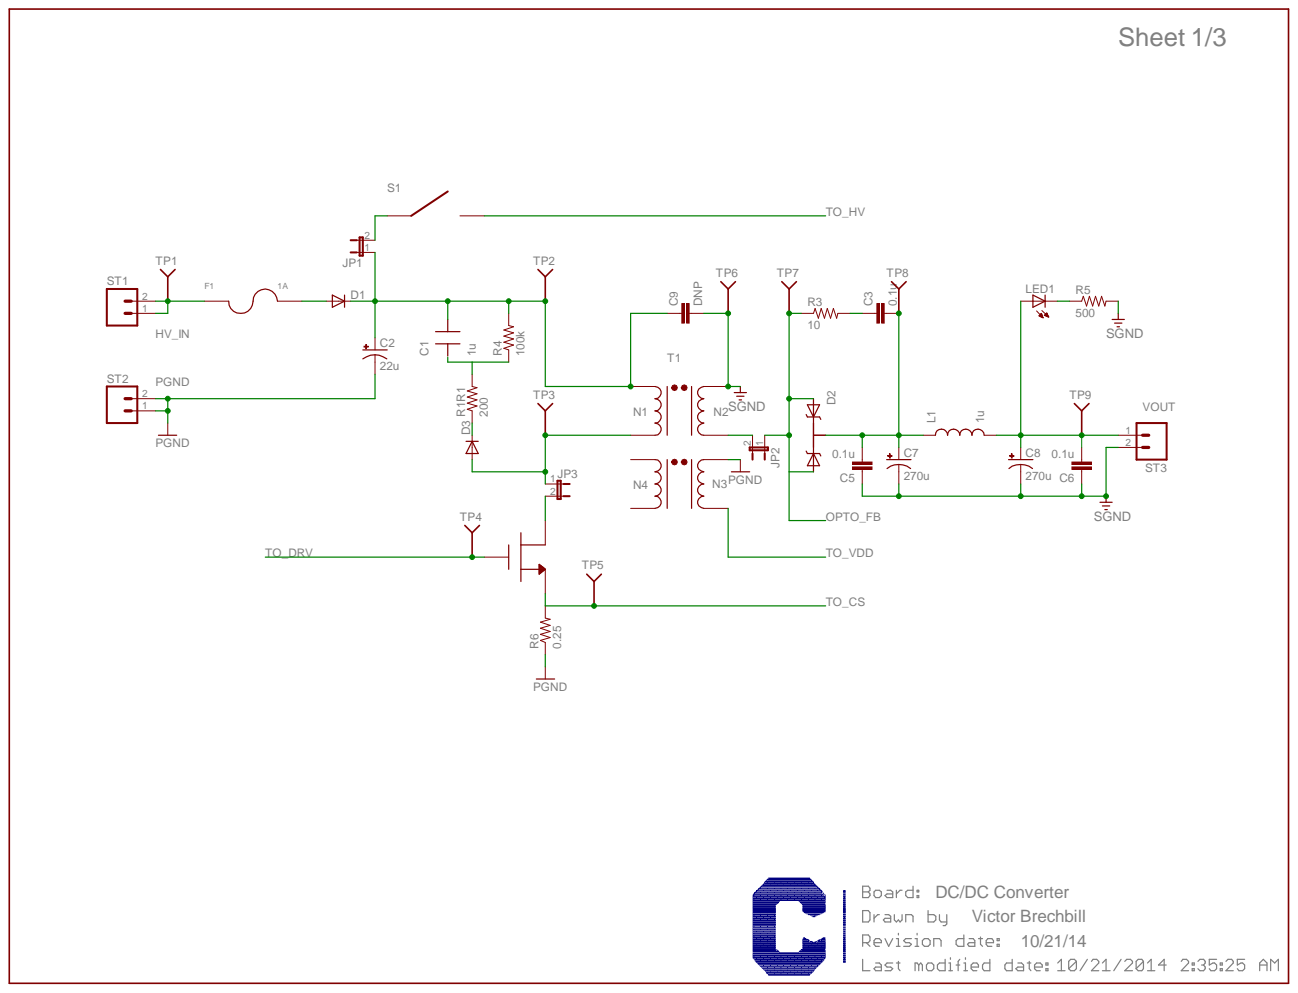
[picture p40: page 1]

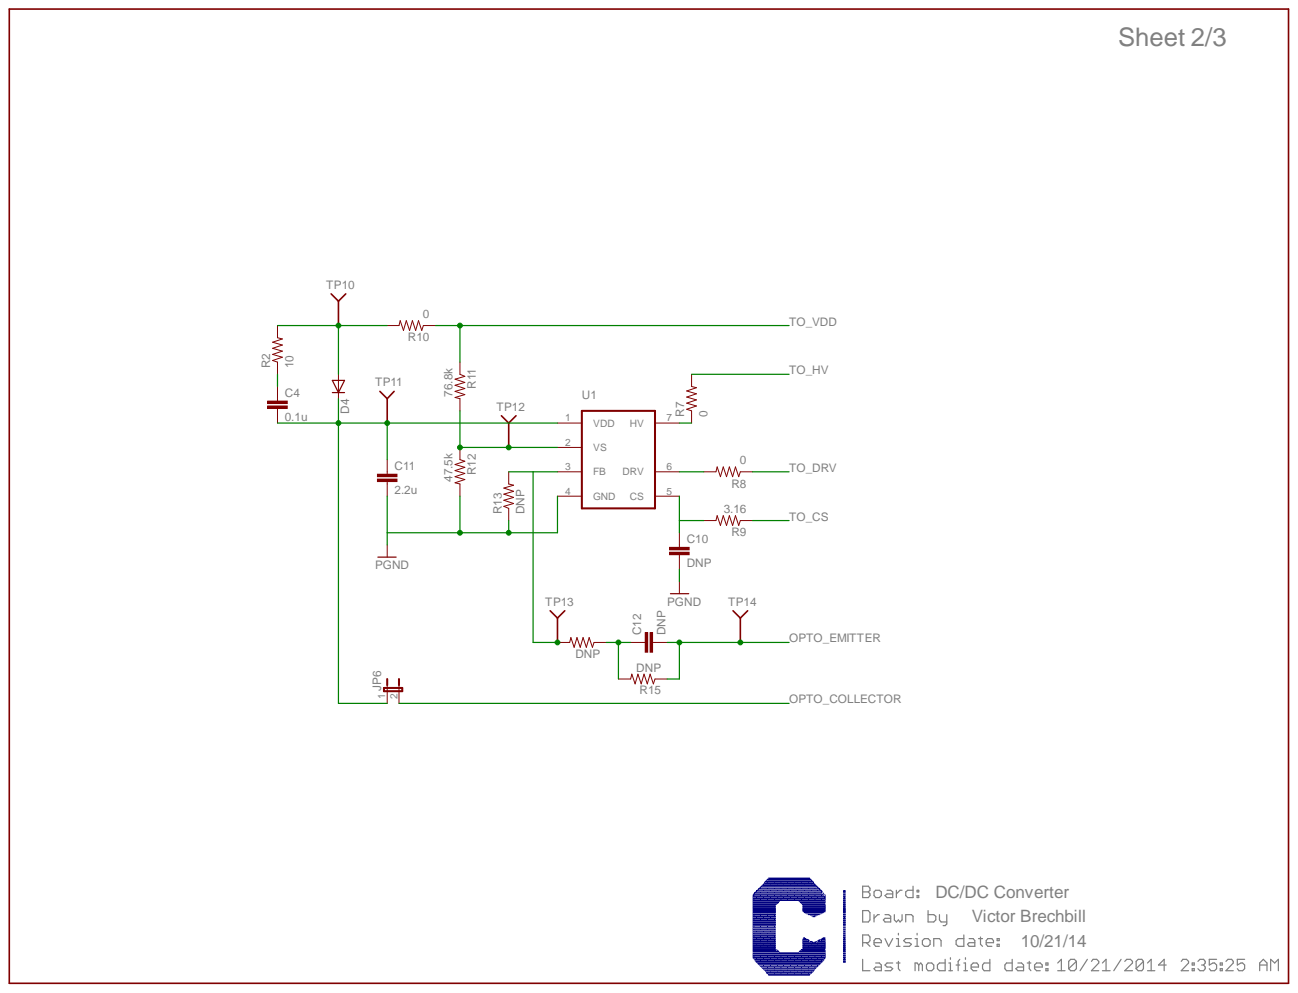
[picture p41: page 2]

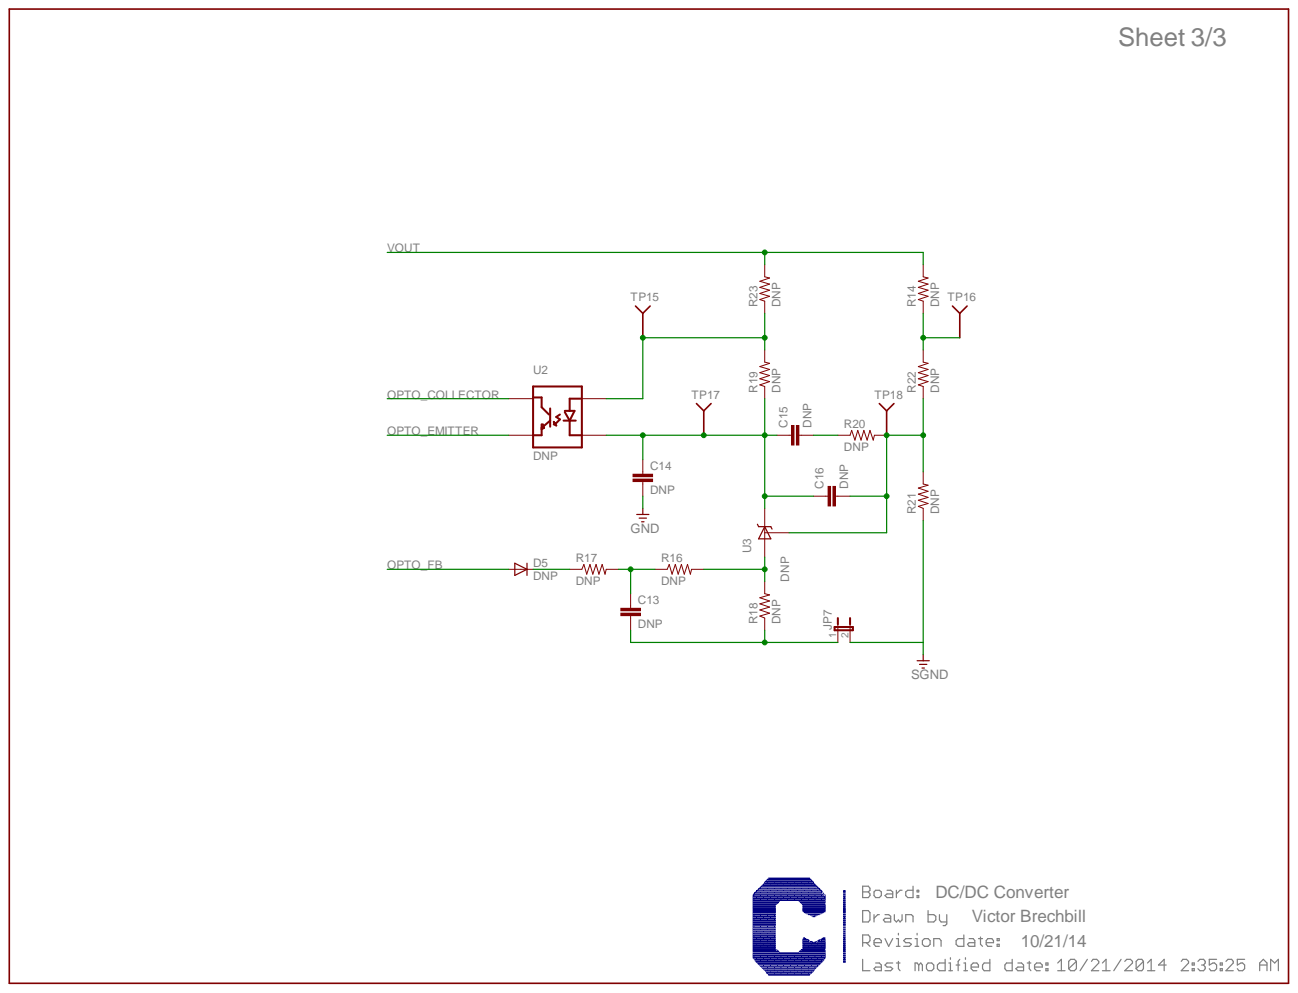
[picture p42: page 3]
