Victorb101/DC-DC-Converter/(commit log)

2014-10-19 Created new Eagle project and initialized .sch and .brd
    [DC-DC-v1.0.0.brd, DC-DC-v1.0.0.sch]
2014-10-22 Finished DC/DC schematic v1.0.0
    [DC-DC Converter.brd, DC-DC Converter.sch]
2014-10-23 Preliminary Board Layout Complete
    [DC-DC Converter.brd, DC-DC Converter.sch, DC-DC-v1.0.0.brd, DC-DC-v1.0.0.sch]
2014-10-23 DC-DC v1.0.0 Complete
    [DC-DC Converter.brd, DC-DC Converter.sch]
2014-10-28 New board layout with non-dissipative LC snubber
    [DC-DC Converter.brd, DC-DC Converter.sch]
2014-10-29 Board Layout and Schematic v1.0.0 complete and PO submitted
    [BOM.xlsx, DC-DC Converter.brd, DC-DC Converter.sch]
2014-11-28 Updated with testing results up to 11-28-14
    [12mCap.SLDPRT, 14005.SLDPRT, 8mCap.SLDPRT, BOM.xlsx, Board_Assembly.SLDASM, Bobbin_ETD34.sldprt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]
2015-01-23 Updated schematic to Version 1.1 to represent changes made in preliminary testing.
    [DC-DC Converter v1.1.brd, DC-DC Converter v1.1.sch]
2015-01-23 Created folder of up to data info about converter
    [DC-DC Converter v1.1.brd, DC-DC Converter v1.1.sch]
2015-01-29 Updated CAD, schematic, and library to represent changes from testing
    [12mCap.SLDPRT, 14005.SLDPRT, 8mCap.SLDPRT, Board_Assembly.SLDASM, Bobbin_ETD34.sldprt, Core_ETD34.sldprt, Cover_ETD34.sldprt, DC-DC Converter v1.1.brd]
